seandw/impetus-clock/doc/inv.tex

\chapter{Inventory}

\section{Parts List}
\begin{tabular}{| l | l | l | l |}
  \hline
  \textbf{Part Name} & \textbf{Quantity} & \textbf{Total Price} &
  \textbf{Distributor} \\ \hline
  7-Segment Serial Display & 1 & \$13 & SparkFun \\ \hline
  ADMP401 MEMS Microphone Breakout & 1 & \$10 & SparkFun \\ \hline
  Arduino Pro Mini & 1 & \$0 & IEEE Workshop \\ \hline
  Box & 1 & \$0 & Spare Part \\ \hline
  Cables (USB/Ethernet) & 2 & \$0 & Spare Part \\ \hline
  FTDI Cable & 1 & \$20 & Adafruit \\ \hline
  Mini Buzzer & 1 & \$4 & RadioShack \\ \hline
  MLX6014ESF-BCF IR Themometer & 1 & \$27 & Digi-Key \\ \hline
  Raspberry Pi Case & 1 & \$0 & Spare Part \\ \hline
  Raspberry Pi GPIO Breakout & 1 & \$8 & Adafruit \\ \hline
  Raspberry Pi Model B Revision 2 & 1 & \$35 & Newark/element14
  \\ \hline
  Wires/Headers & 2 & \$5 & SparkFun \\ \hline
\end{tabular}
