seandw/impetus-clock/doc/manual.tex

\documentclass[12pt,letterpaper]{report}
\usepackage[margin=1in]{geometry}
\usepackage{gensymb}
\usepackage{fixltx2e}
\usepackage{graphicx}

\begin{document}
\title{Impetus: Technical User Manual for a Presence-Detecting Alarm
  Clock}
\author{Sean Webster, A08992738}
\date{\today}
\maketitle

\tableofcontents

\input{intro}

\input{hw}

\input{sw}

\input{op}

\input{inv}

\end{document}
