seandw/impetus-clock/arduino/impetus/impetus.ino

#include <i2cmaster.h>
#include <SoftwareSerial.h>

SoftwareSerial display(8, 9);

int mphonePin = 0;
int buzzPin = 10;
int cycle = 0, vol = 0;
double temp = 0;
boolean flash = false, sample = false, alarm = false, buzz = LOW;

void setup(){
  Serial.begin(9600);
  
  display.begin(9600);
  display.write(0x76);
  display.write(0x7A);
  display.write(0b11111111);
  
  i2c_init(); //Initialise the i2c bus
  PORTC = (1 << PORTC4) | (1 << PORTC5);//enable pullups
  
  float ref = readAmb();

  display.write((int) ref / 10);
  display.write((int) ref % 10);
  display.write((int)(ref * 10) % 10);
  display.write((int)(ref * 100) % 10);

  pinMode(mphonePin, INPUT);
  pinMode(buzzPin, OUTPUT);
}

void serialEvent() {
  while (Serial.available()) {
    char in = (char) Serial.read();
    if (in == 's') {
      display.write(0x7A);
      display.write(0b11111111);
      sample = false;
      alarm = true;
      temp = 0;
      vol = 0;
      cycle = 0;
    } else if (in == 'R') { // RESET
      cycle = vol = 0;
      temp = 0;
      sample = alarm = false;
      display.write(0x79);
      display.write((byte) 0);
      display.write(0x7A);
      display.write(0b11111111);
    } else {
      display.write(in);
    }
  }
}

float mlxRead(byte loc){
  int dev = 0x5A<<1;
  int data_low = 0;
  int data_high = 0;
  int pec = 0;
  
  i2c_start_wait(dev+I2C_WRITE);
  i2c_write(loc);
  
  // read
  i2c_rep_start(dev+I2C_READ);
  data_low = i2c_readAck(); //Read 1 byte and then send ack
  data_high = i2c_readAck(); //Read 1 byte and then send ack
  pec = i2c_readNak();
  i2c_stop();
  
  //This converts high and low bytes together and processes temperature, MSB is a error bit and is ignored for temps
  double tempFactor = 0.02; // 0.02 degrees per LSB (measurement resolution of the MLX90614)
  double tempData = 0x0000; // zero out the data
  int frac; // data past the decimal point
  
  // This masks off the error bit of the high byte, then moves it left 8 bits and adds the low byte.
  tempData = (double)(((data_high & 0x007F) << 8) + data_low);
  tempData = (tempData * tempFactor)-0.01;
  
  float celcius = tempData - 273.15;
  float fahrenheit = (celcius*1.8) + 32;
  
  return fahrenheit;
}

float readTemp() {
  return mlxRead(0x07);
}

float readAmb() {
  return mlxRead(0x06);
}

int readVol() {
  int readings[50], minR = 1023, maxR = 0;
  for (int i = 0; i < 50; i++) {
    readings[i] = analogRead(mphonePin);
    delay(1);
  }
  for (int i = 0; i < 50; i++) {
    if (readings[i] > maxR)
      maxR = readings[i];
    else if (readings[i] < minR)
      minR = readings[i];
  }
  return maxR-minR;
}

void loop() {
  if (sample) {
    float tt = readTemp();
    int tv = readVol();
    if (tt > temp)
      temp = tt;
    if (tv > vol)
      vol = tv;
    cycle++;
    if (cycle == 60) {
      cycle = 0;
      if (Serial) {
        Serial.print(temp);
        Serial.print(" ");
        Serial.print(readAmb());
        Serial.print(" ");
        Serial.println(vol);
      }
      temp = 0;
      vol = 0;
    }
  } else {
    if (alarm && readTemp() <= readAmb() + 5)
      cycle++;
    else if (!alarm && readTemp() > readAmb() + 5)
      cycle++;
    else
      cycle = 0;
    if (cycle > 10 && alarm)
      buzz = true; // Don't buzz, but still be able to reset.  
    if (cycle == 60) {
      if (alarm) {
        alarm = false;
        display.write(0x7A);
        display.write(0b11111111);
      } else {
        sample = true;
        display.write(0x7A);
        display.write(0b01111111);
        if (Serial)
          Serial.println("S");
      }
      cycle = 0;
    }
  } 
  
  if (alarm || buzz) {
    buzz = !buzz;
    digitalWrite(buzzPin, buzz);
  }
  
  flash = !flash;
  display.write(0x77);
  display.write(flash << 4 | sample << 3 | alarm | alarm << 1 | alarm << 2 | alarm << 3);
  
  delay(1000); // wait a second before printing again
}
