seandw/impetus-clock/(commit log)

2013-05-12 Initial code for the Raspberry Pi side of things. Only demonstrates that it can actually communicate with the Arduino side.
2013-05-14 Initial code for the Arduino side of the project.
    Currently gets readings from the IR temperature sensor and relays it
    to the Raspberry Pi.
2013-05-14 Forgot I2Cmaster.
2013-06-01 Sends temperature and sound volume data, takes in time.
    Restructured more like an Arduino project.
2013-06-02 Added the different states of the Arduino.
    Still don't know what way is best to check for whether the user has
    left or not.
2013-06-03 Arduino uses ambient temperature as a threshold against the object temperature.
    Forgot this sensor had that ability...
2013-06-04 Alarm and sampling checks take a minute, added reset commands.
    Brightness is lowered in the sampling state as well. This is the last
    Arduino commit unless some glaring error shows up.
    [impetus.ino]
2013-06-04 Scheduling is implemented in a new process.
    Lots of work to make this... not ugly, but unless something completely
    breaks, this is the final RPi commit.
    It's important to note that impetus.conf requires an 'alarm' section
    now. Didn't update the skeleton, my bad.
    [impetus.py]
2013-06-04 Initial manual commit.
    And some Arduino commit that looks trivial, but I'm sleep deprived.
    I hear saving early and often is a good idea.
2013-06-04 Scope issues with __main__. That's what I get for not knowing Python.
    Multiple plots on a single figure also fixed.
    [impetus.py]
